Rishthegreat/KiCadCustomGlobalLib/3dmodels/XRCGB24M000F3A00R0.stp

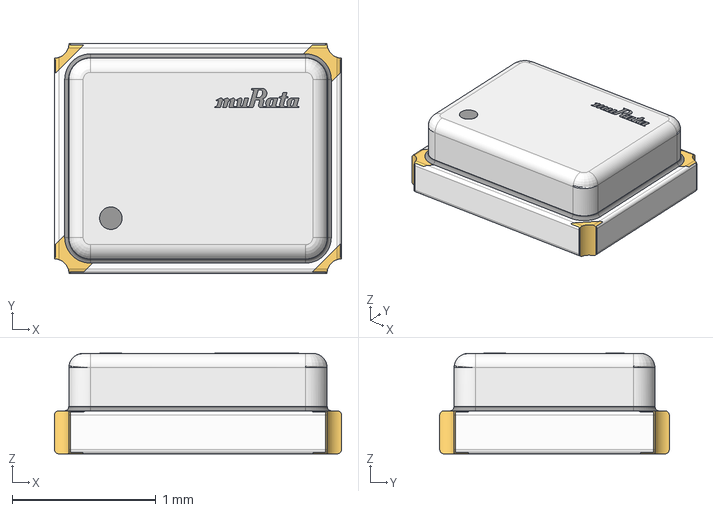
[picture p1: CAD file, 2025-07-02]
3dmodels/XRCGB24M000F3A00R0.stp
2.00 x 1.60 x 0.702 mm
