Rishthegreat/KiCadCustomGlobalLib/3dmodels/BSC014N06NS.stp

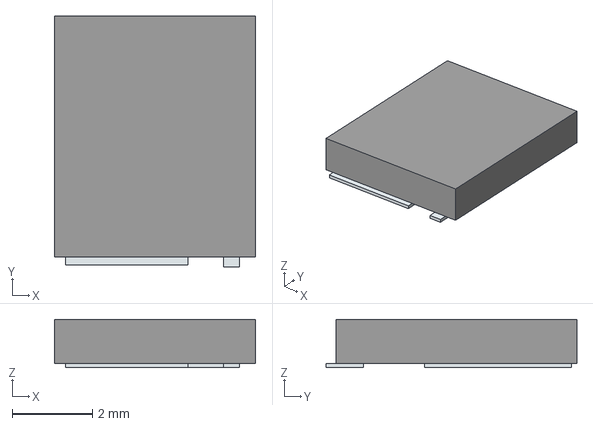
[picture p2: CAD file, 2025-07-01]
3dmodels/BSC014N06NS.stp
5.00 x 6.24 x 1.20 mm
Pins
