Rishthegreat/KiCadCustomGlobalLib/3dmodels/DRV8323RSRGZR.stp

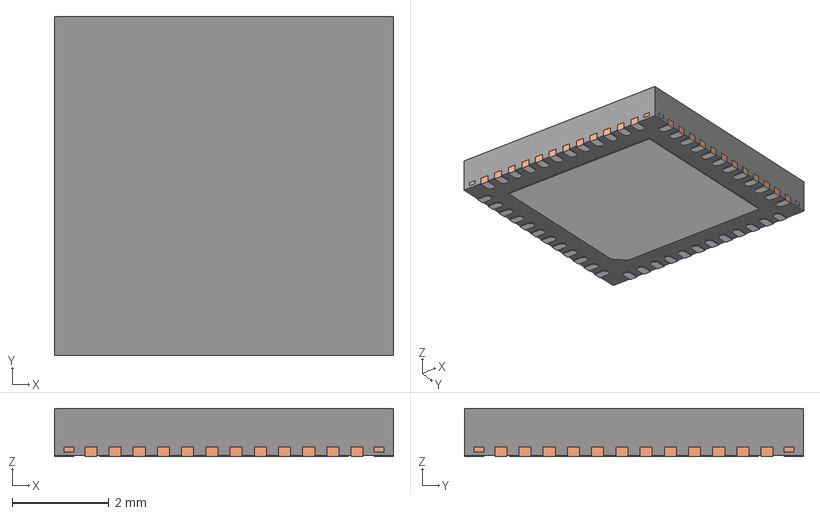
[picture p3: CAD file, 2025-07-01]
3dmodels/DRV8323RSRGZR.stp
7.00 x 7.00 x 1.00 mm
BODY-QFN
FRAME-RGZ0048A
PIN1-ID
