Rishthegreat/KiCadCustomGlobalLib/3dmodels/62701021621.stp

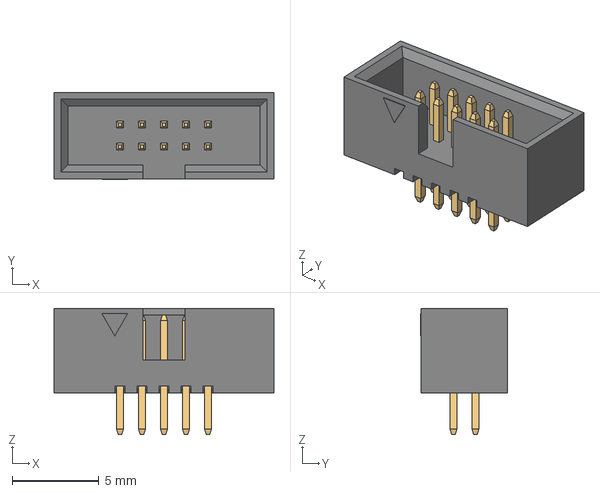
[picture p4: CAD file, 2025-07-01]
3dmodels/62701021621.stp
12.7 x 5.05 x 7.30 mm
6270xx21621_Pin x 10
